sidirima/theremino_labview/README.md

# Ultrasonic Theremin using Arduino Nano and LabVIEW
The purpose of this project is to implement a **Theremin**, an electronic musical instrument, using ultrasonic sensors and a simple Arduino-family microcontroller. We use serial connection between the microcontroller and a computer, so as to have a **visual representation of the sensor measurements** using the National Instruments LabVIEW software. 

This project is a practical experiment in the usage of **LabVIEW** software and the **VISA library plugin** (Virtual Instrument Software Architecture).

## Project Index

#### 1. [Arduino Code](/Arduino_code) 
The folder contains the code used for Arduino microcontroller

#### 2. [LabVIEW visualization file](/LabVIEW)
The folder contains the LabVIEW designed system files for visualization of the Theremin pitch and volume parameters

#### 3. [Schematics / Designs](/Schematics)
The folder contains the schematics of the project, designed in EasyEDA and fritzing, and also the .STL files for the case enclosure

#### 4. Pictures / Videos

## What is a Theremin?
The Theremin was invented by Leon Theremin, a Soviet engineer in the 1920s. It is a wooden or plastic box with two metal antennas, one vertical and one horizontal. The vertical antenna is used for pitch variation and the horizontal one for volume variation. The circuitry inside the box is responsible for sound generation. The thereminist is using their hands movements to alter the sound of the instrument.

<p align = "center">
  
</p>

## How does a Theremin work?
As we see in the block diagram of the instrument below, the two antennas are connected to two oscillators. The first oscillator is responsible for the volume of the generated sound. Using a **bandpass filter**, we set the maximum and minimum value accordingly.
The second oscillator is responsible for the pitch variation. The instrument uses a mixer to correspond the signal created via the pitch oscillator with a reference signal. The two signals are then combined and amplified in order for a sound to be heard via the speaker.

<p align = "center">
  
</p>

The antennas are essentially one electrode of a capacitor, with the hand of the thereminist being the other electrode. Thus, by the hand movements there is a variation in the capacitive load of the oscillators. For instance, if the thereminist holds their one hand position over the volume antenna and moves their other hand, there is only a pitch variation with a stable volume.

## Our project circuitry
To design the circuit of the project, we use [fritzing](https://fritzing.org/), an open source cross-platform designer program which is quite easy to use and allows sketch design for simple Arduino projects. The only downside is that it has a limited amount of components. The circuit is the one in the image below.
<p align = "center">
  Theremino Sketch_bb
</p>

### Parts Used for project
- 1x Arduino Nano
- 2x HC-SR04 Ultrasonic Sensors
- 1x LM386 Audio Amplifier
- 1x MCP41010  10kΩ Digital Potentiometer
- 1x 470kΩ Rotary Potentiometer
- 1x 10μF Electrolytic Capacitor
- 1x 100nF Electrolytic Capacitor
- 1x 220μF Εlectrolytic Capacitor
- 1x 50nF Ceramic Capacitor
- 1x 10Ω Resistor
- 1x Speaker 4Ω, 3V

## Ultrasonic Sensor Working Principle
Instead of using our hands to vary the capacitance used in the oscillators, we use two ultrasonic sensor modules, one for varying the pitch and the other for varying the volume of the generated signal. These sensors are based on the principle of sound wave reflection, in this particular case an ultrasonic one (>20kHz). As we can see in the picture below, the sensor module has two metal barrels, one containing the sound transmitter and the other the receiver. This wave will bounce in every obstacle in its way, in our case it would be the hand of the thereminist and return to the receiver. The distance calculation is performed by using the time difference between transmission and reception of the signal.

<p align = "center">
  
</p>

The generated sound is nothing but a square wave signal with variable frequency and amplitude. The frequency parameter is defined by the "Pitch" ultrasonic sensor value, whereas the amplitude parameter is defined by the "Volume" sensor value.

## Is the Digital Potentiometer necessary?
The digital potentiometer used is manufactured by Microchip, and it is a non-volatile 10kΩ variable resistance. The IC we selected uses the SPI serial protocol for communication with the microcontroller. The reason for selecting it is the packaging, which is a standard DIP-8, making it easy to test on a breadboard or solder to a PCB. 

In our case, we use this potentiometer to translate the digital output signals of the Arduino microcontroller to voltage. The use of this potentiometer is a necessity if we want to keep the "handsfree" principle of the original theremin instrument. With the use of the digital potentiometer, volume and pitch are only controlled by the parameters of the ultrasonic sensors.

Although, in the end we end up using a simple 470kΩ rotary potentiometer as well, acting as a "Master Volume" knob for the instrument.

## Audio Amplification
The signals generated via the Arduino microcontroller are not "speaker level" signals in order to be heard properly. Thus, we need to amplify and normalize the generated sound signals.
In order to achieve this, we need to use a specified Audio Amplifier IC, such as the LM386. This IC can safely drive a 4Ω or 8Ω speaker using a low voltage power source, in our case a +9V DC power supply or a 9V battery. 

The difference between the LM386 and other more common operational amplifier ICs (such as the LM741) is that those ICs have a max output current of 20mA, thus we need a load of very high resistance in order for them to function properly. Using a non-audio specific amplifier IC would require the use of external Push-Pull stages, making the circuit rather complex and ineffective due to high pricing of the components.

<p align = "center">
  Schematic_LM386-Amplifier_2026-10-22
</p>

As we can see in the schematic diagram above, the audio amplifier section of the project is a non-inverting amplifier with a standard voltage gain of 20, due to the fact that the gain pins of the IC are not connected. C1 is bypass and C2 is a decoupling capacitor, one connected to the IC and the other for voltage filtering. C3 and R1 form a [Zobel Network](https://www.wavecor.com/html/zobel_networks.html) filter that is used for impedance linearization of the drive speaker. Specifically, it cutoffs the voice coil inductance in high frequencies. These components values are suggested in the datasheet for LM386.

Then, capacitor C4 is used as a passive First Order Highpass filter with cutoff frequency of 180 Hz using a 4Ω speaker. This is calculated using the mathematical expression below:

$$\ f = {1 \over {2πRC_4}} = {1 \over {2π \cdot 4Ω \cdot 220μF}} \approx 181 Hz $$ 

## Using LabVIEW for visualization
[LabVIEW](https://www.ni.com/en/shop/labview.html?srsltid=AYCX9vL26RLTX9zwwPdzUQJAdKk94lcwBNWDP5UKMtAPKmJHZS46p3xI) stands for _Laboratory Virtual Instrument Engineering Workbench_ and is a graphical programming environment that allows a user to design and test systems with an intuitive programming perspective. It can be used alongside **Data Acquisition (DAQ)** systems for monitoring sensors in industrial systems. With the use of its libraries we can achieve rather complex measurement system design.

You can view the National Instruments presentation video about LabVIEW by clicking the thumbnail below:
<p align = "center">
<a href="http://www.youtube.com/watch?feature=player_embedded&v=w7z50E2vQZ8
" target="_blank">IMAGE ALT TEXT HERE</a>
</p>

For enabling communication between LabVIEW and Arduino microcontroller we will use the **VISA library** I/O tools. Also, we need to use simple string functions to isolate the data read from the COM port of the Arduino. Specifically, we use the modules below:

### **_VISA Configure Serial Port_**
This specific module initializes the serial port communication between the Arduino's USB port and LabVIEW. In the image below, we can see the module structure. 
<p align = "center">
  
</p>

In _VISA resource name_ field we define a constant with the COM port number that is used by the Arduino. _baud rate_ default is 9600. We chain connect the _VISA resource name out_ and _error out_ with the next VISA modules.

### **_VISA Read_**
This module is used to read specific number of bytes from the VISA resource name interface. Its structure is shown in the image below.
<p align = "center">
  
</p>

In _byte count_ field we define a number of bytes to read from the COM port of the Arduino. The _read buffer_ is the "output" for those data.

### **_VISA Close_**
This module is used to finalize the period of communication defined by the VISA resource name
<p align = "center">
  
</p>

### **_Scan from String_**
This module specifies the data types of an input string, in our case the _read buffer_ from VISA Read module and extract the data according to the format specified in _format string_ field.
<p align = "center">
  
</p>

### **_Numeric Indicators_**
We use two seperate numeric indicators for visualization of the parameters value read from the Ultrasonic Sensors
<p align = "center">
  

</p>

### **_Boolean Indicators_**
The boolean indicators we use are to monitor the octaves and notes calculated via a LabVIEW case structure
<p align = "center">
  
</p>

### **_Case Structure_**
The classic switch - case structure. We use 2 of these case structures, one to define the octave and one to define the note of each octave. On the image below we can see the case selector when the note is B6.
<p align = "center">
  
</p>
