sidirima/theremino_labview/Schematics/fritzing_sketch.png

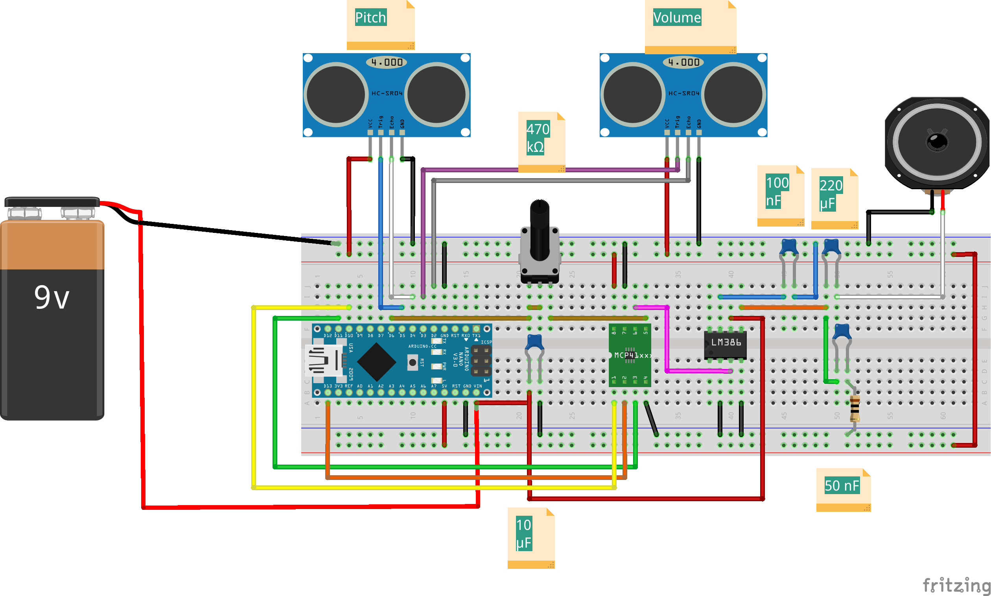
Schematics/fritzing_sketch.png
