sidirima/theremino_labview/Schematics/Schematic_Theremino.png

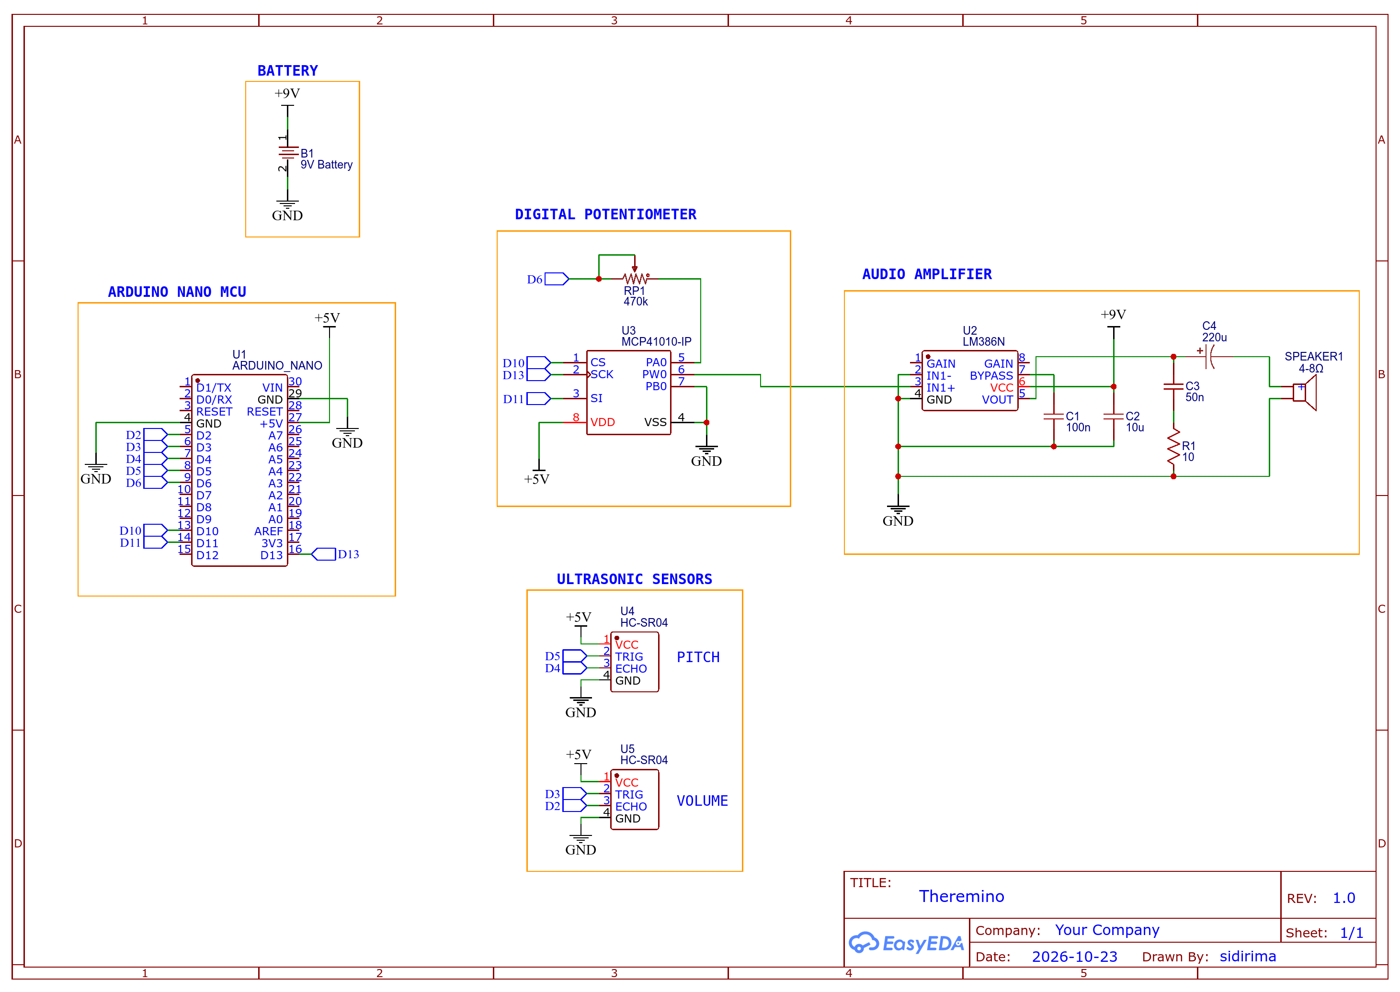
Schematics/Schematic_Theremino.png
